wooshykeshcollege/turdsla_temp_files/V15.0/AIO/AIO.kicad_pcb

## KiCad design V15.0/AIO/AIO.kicad_pcb (2022-10-14)

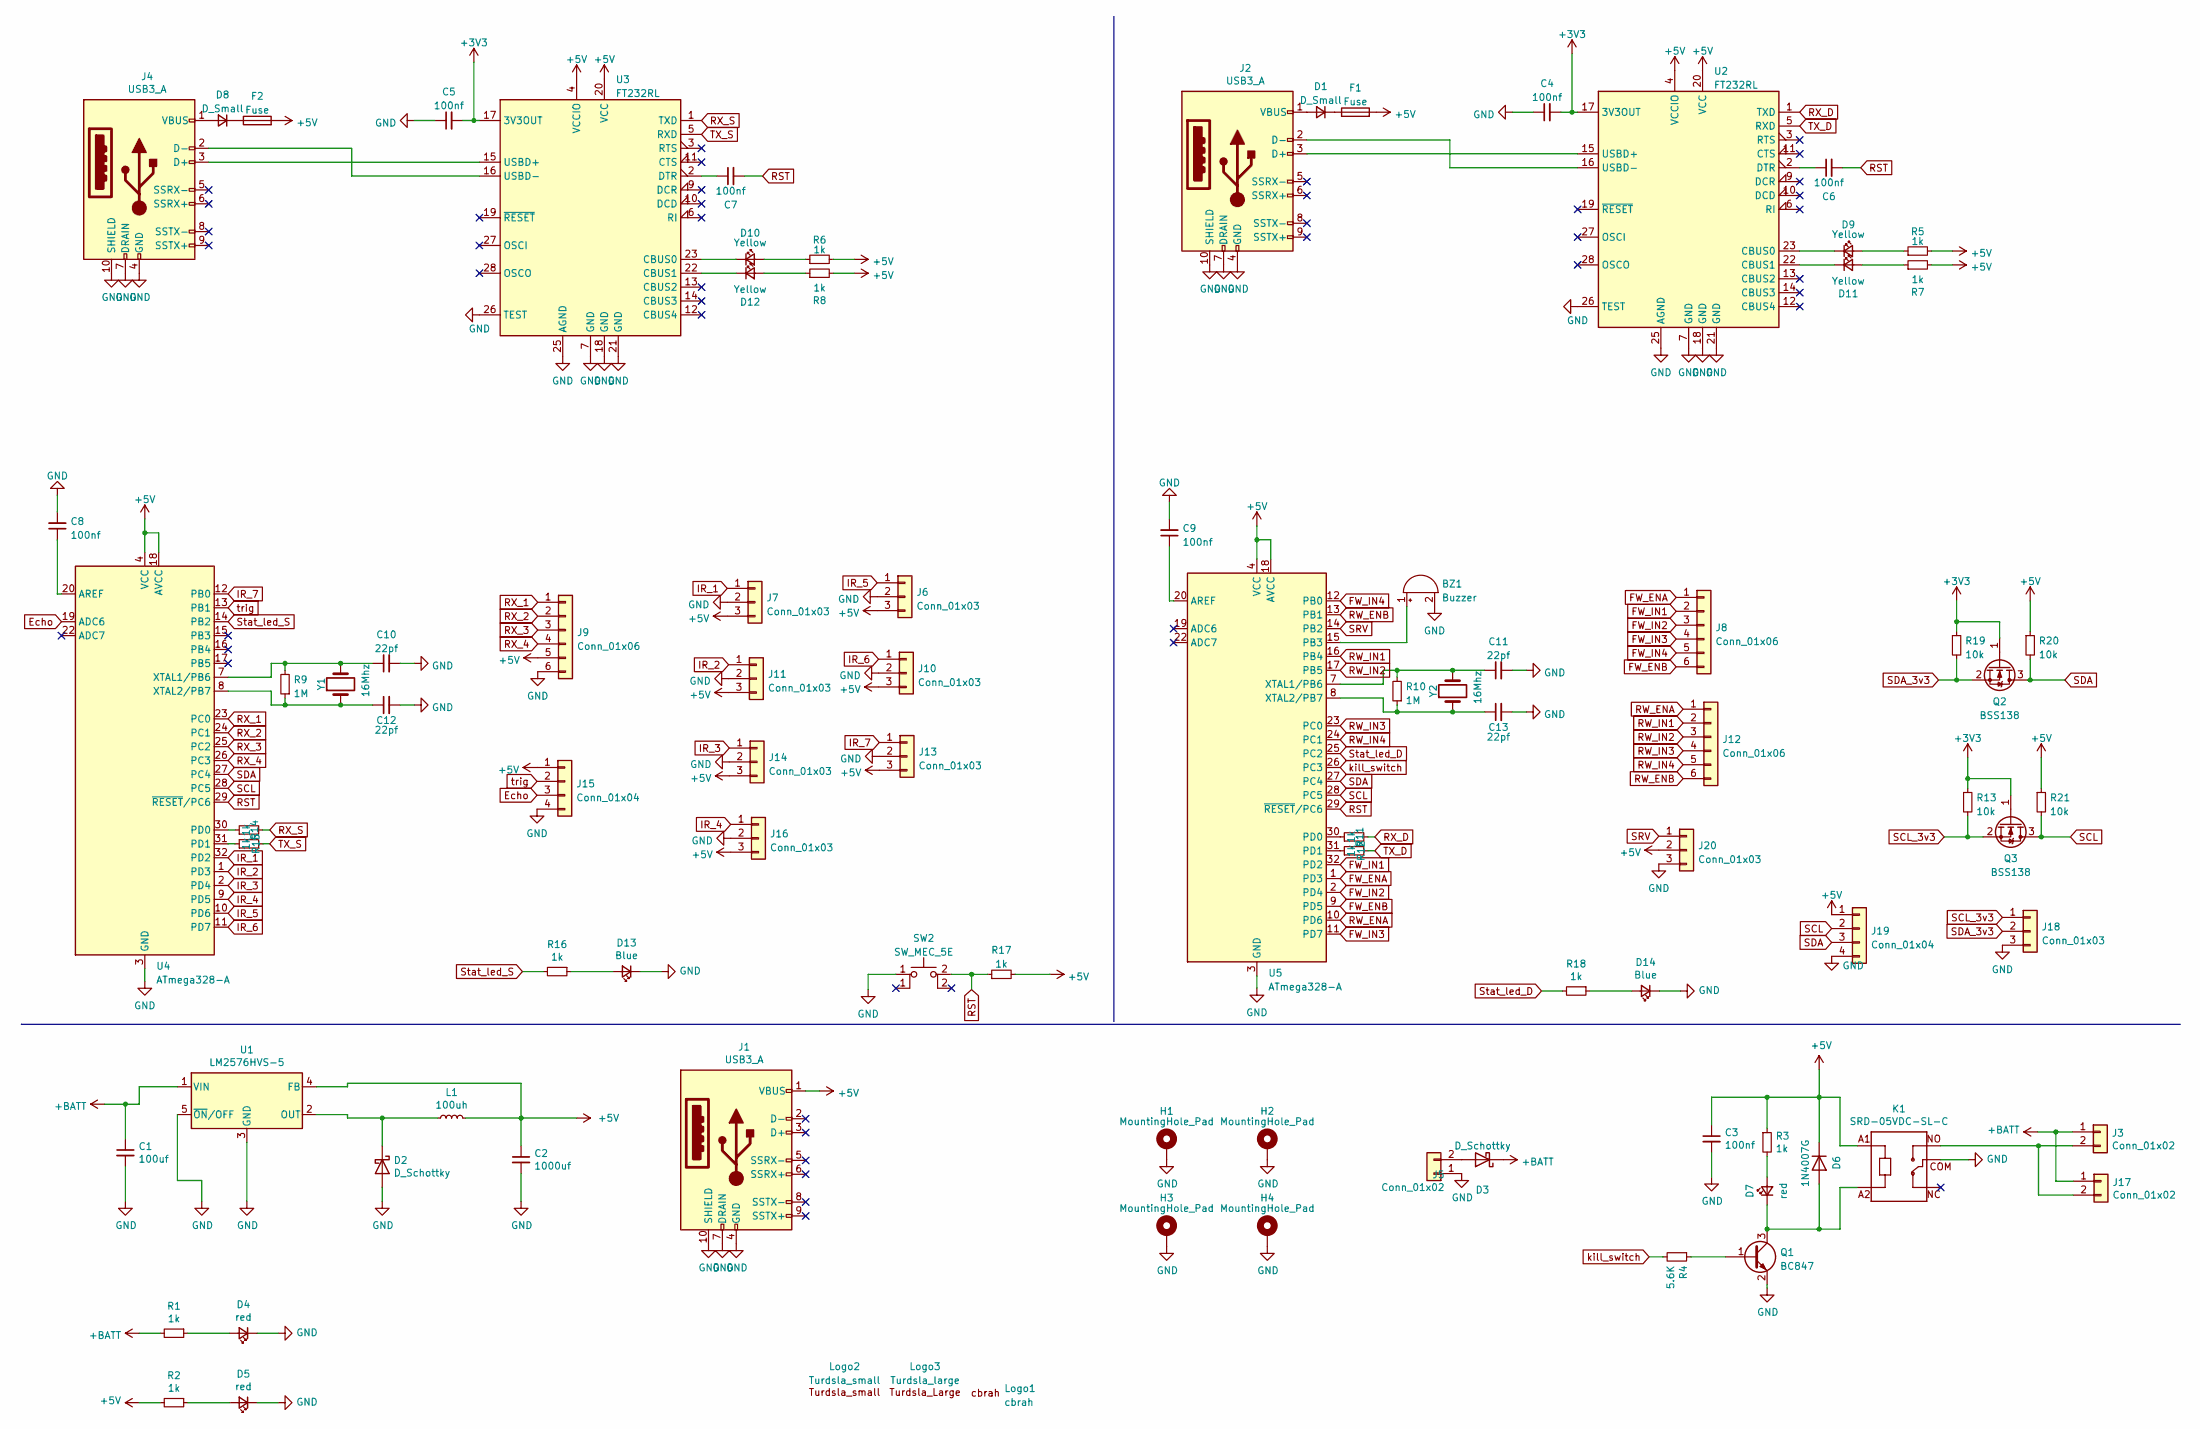
[picture p1: schematic AIO.kicad_sch]

Parts:
BZ1: Buzzer; MagneticBuzzer_ProSignal_ABI-009-RC
C1: 100uf; CP_Elec_6.3x7.7; LCSC PART# C72477
C2: 1000uf; cap_12.5x13.5; LCSC PART# C191226
C3, C4, C5, C6, C7, C8, C9: 100nf; C_1206_3216Metric; LCSC PART# C271438
C10, C11, C12, C13: 22pf; C_1206_3216Metric
D1, D8: D_Small; D_SOD-123
D2, D3: D_Schottky; schottky_diode; LCSC PART# C466483
D4, D5, D7: red; LED_1206_3216Metric; LCSC PART# C88326
D6: 1N4007G; SMAF; LCSC PART# C110856
D9, D10, D11, D12: Yellow; LED_1206_3216Metric; LCSC PART# C88326
D13, D14: Blue; LED_1206_3216Metric; LCSC PART# C88326
F1, F2: Fuse; Fuse_1210_3225Metric
H1, H2, H3, H4: MountingHole_Pad; MountingHole_3.2mm_M3_Pad_Via
J1, J2, J4: USB3_A; usb_3_female
J3, J17: Conn_01x02; TerminalBlock_bornier-2_P5.08mm
J5: Conn_01x02; AMASS_XT60-M_1x02_P7.20mm_Vertical
J6, J7, J10, J11, J13, J14, J16, J18, J20: Conn_01x03; PinHeader_1x03_P2.54mm_Vertical
J8, J9, J12: Conn_01x06; PinHeader_1x06_P2.54mm_Vertical
J15, J19: Conn_01x04; PinHeader_1x04_P2.54mm_Vertical
K1: SRD-05VDC-SL-C; Relay_SPDT_SANYOU_SRD_Series_Form_C; LCSC PART# C35449
L1: 100uh; LCSC PART# C408533
Logo1: cbrah; cbrah60
Logo2: Turdsla_small; Turdsla
Logo3: Turdsla_large
Q1: BC847; SOT-23
Q2, Q3: BSS138; SOT-23
R1, R2, R3, R5, R6, R7, R8, R11, R12, R14, R15, R16, R17, R18: 1k; R_1206_3216Metric; LCSC PART# C280032
R4: 5.6K; R_1206_3216Metric; LCSC PART# C844437
R9, R10: 1M; R_1206_3216Metric
R13, R19, R20, R21: 10k; R_1206_3216Metric; LCSC PART# C280032
SW2: SW_MEC_5E; SW_PUSH_6mm_H4.3mm
U1: LM2576HVS-5; TO-263-5_TabPin3; LCSC PART# C194472
U2, U3: FT232RL; SSOP-28_5.3x10.2mm_P0.65mm
U4, U5: ATmega328-A; TQFP-32_7x7mm_P0.8mm
Y1, Y2: 16Mhz; Crystal_SMD_SeikoEpson_MC405-2Pin_9.6x4.1mm

Connections:
+3V3: C4.2, C5.2, Q2.1 (G), Q3.1 (G), R13.1, R19.1, U2.17 (3V3OUT), U3.17 (3V3OUT)
+5V: C2.1, C3.1, D6.1 (K), F1.2, F2.2, J1.1 (VBUS), J6.3, J7.3, J9.5, J10.3, J11.3, J13.3, J14.3, J15.1, J16.3, J19.1, J20.2, K1.A1, L1.2, R2.2, R3.1, R5.2, R6.2, R7.2, R8.2, R17.2, R20.1, R21.1, U1.4 (FB), U2.4 (VCCIO), U2.20 (VCC), U3.4 (VCCIO), U3.20 (VCC), U4.4 (VCC), U4.6 (VCC), U4.18 (AVCC), U5.4 (VCC), U5.6 (VCC), U5.18 (AVCC)
+BATT: C1.1, D3.1 (K), J3.1, J17.1, R1.2, U1.1 (VIN)
Echo: J15.3, U4.19 (ADC6)
FW_ENA: J8.1, U5.1 (PD3)
FW_ENB: J8.6, U5.9 (PD5)
FW_IN1: J8.2, U5.32 (PD2)
FW_IN2: J8.3, U5.2 (PD4)
FW_IN3: J8.4, U5.11 (PD7)
FW_IN4: J8.5, U5.12 (PB0)
GND: BZ1.2 (+), C1.2, C2.2, C3.2, C4.1, C5.1, C8.2, C9.2, C10.2, C11.2, C12.2, C13.2, D2.2 (A), D4.1 (K), D5.1 (K), D13.1 (K), D14.1 (K), H1.1, H2.1, H3.1, H4.1, J1.4 (GND), J1.7 (DRAIN), J1.10 (SHIELD), J2.4 (GND), J2.7 (DRAIN), J2.10 (SHIELD), J4.4 (GND), J4.7 (DRAIN), J4.10 (SHIELD), J5.1, J6.2, J7.2, J9.6, J10.2, J11.2, J13.2, J14.2, J15.4, J16.2, J18.3, J19.4, J20.3, K1.COM, Q1.2 (E), SW2.1, U1.3 (GND), U1.5 (~ON/OFF), U2.7 (GND), U2.18 (GND), U2.21 (GND), U2.25 (AGND), U2.26 (TEST), U3.7 (GND), U3.18 (GND), U3.21 (GND), U3.25 (AGND), U3.26 (TEST), U4.3 (GND), U4.5 (GND), U4.21 (GND), U5.3 (GND), U5.5 (GND), U5.21 (GND)
IR_1: J7.1, U4.32 (PD2)
IR_2: J11.1, U4.1 (PD3)
IR_3: J14.1, U4.2 (PD4)
IR_4: J16.1, U4.9 (PD5)
IR_5: J6.1, U4.10 (PD6)
IR_6: J10.1, U4.11 (PD7)
IR_7: J13.1, U4.12 (PB0)
unnamed: BZ1.1 (-), U5.15 (PB3)
unnamed: C6.1, U2.2 (DTR)
unnamed: C7.1, U3.2 (DTR)
unnamed: C8.1, U4.20 (AREF)
unnamed: C9.1, U5.20 (AREF)
unnamed: C10.1, R9.2, U4.7 (XTAL1/PB6), Y1.2
unnamed: C11.1, R10.2, U5.7 (XTAL1/PB6), Y2.2
unnamed: C12.1, R9.1, U4.8 (XTAL2/PB7), Y1.1
unnamed: C13.1, R10.1, U5.8 (XTAL2/PB7), Y2.1
unnamed: D1.1 (K), F1.1
unnamed: D1.2 (A), J2.1 (VBUS)
unnamed: D2.1 (K), L1.1, U1.2 (OUT)
unnamed: D4.2 (A), R1.1
unnamed: D5.2 (A), R2.1
unnamed: D6.2 (A), D7.1 (K), K1.A2, Q1.3 (C)
unnamed: D7.2 (A), R3.2
unnamed: D8.1 (K), F2.1
unnamed: D8.2 (A), J4.1 (VBUS)
unnamed: D9.1 (K), U2.23 (CBUS0)
unnamed: D9.2 (A), R5.1
unnamed: D10.1 (K), U3.23 (CBUS0)
unnamed: D10.2 (A), R6.1
unnamed: D11.1 (K), U2.22 (CBUS1)
unnamed: D11.2 (A), R7.1
unnamed: D12.1 (K), U3.22 (CBUS1)
unnamed: D12.2 (A), R8.1
unnamed: D13.2 (A), R16.1
unnamed: D14.2 (A), R18.1
unnamed: J2.2 (D-), U2.16 (USBD-)
unnamed: J2.3 (D+), U2.15 (USBD+)
unnamed: J4.2 (D-), U3.16 (USBD-)
unnamed: J4.3 (D+), U3.15 (USBD+)
unnamed: D3.2 (A), J5.2
unnamed: J3.2, J17.2, K1.NO
unnamed: Q1.1 (B), R4.1
unnamed: R11.1, U5.30 (PD0)
unnamed: R12.1, U5.31 (PD1)
unnamed: R14.1, U4.30 (PD0)
unnamed: R15.1, U4.31 (PD1)
RST: C6.2, C7.2, R17.1, SW2.2, U4.29 (~RESET/PC6), U5.29 (~RESET/PC6)
RW_ENA: J12.1, U5.10 (PD6)
RW_ENB: J12.6, U5.13 (PB1)
RW_IN1: J12.2, U5.16 (PB4)
RW_IN2: J12.3, U5.17 (PB5)
RW_IN3: J12.4, U5.23 (PC0)
RW_IN4: J12.5, U5.24 (PC1)
RX_1: J9.1, U4.23 (PC0)
RX_2: J9.2, U4.24 (PC1)
RX_3: J9.3, U4.25 (PC2)
RX_4: J9.4, U4.26 (PC3)
RX_D: R11.2, U2.1 (TXD)
RX_S: R14.2, U3.1 (TXD)
SCL: J19.2, Q3.3 (D), R21.2, U4.28 (PC5), U5.28 (PC5)
SCL_3v3: J18.1, Q3.2 (S), R13.2
SDA: J19.3, Q2.3 (D), R20.2, U4.27 (PC4), U5.27 (PC4)
SDA_3v3: J18.2, Q2.2 (S), R19.2
SRV: J20.1, U5.14 (PB2)
Stat_led_D: R18.2, U5.25 (PC2)
Stat_led_S: R16.2, U4.14 (PB2)
TX_D: R12.2, U2.5 (RXD)
TX_S: R15.2, U3.5 (RXD)
kill_switch: R4.2, U5.26 (PC3)
trig: J15.2, U4.13 (PB1)

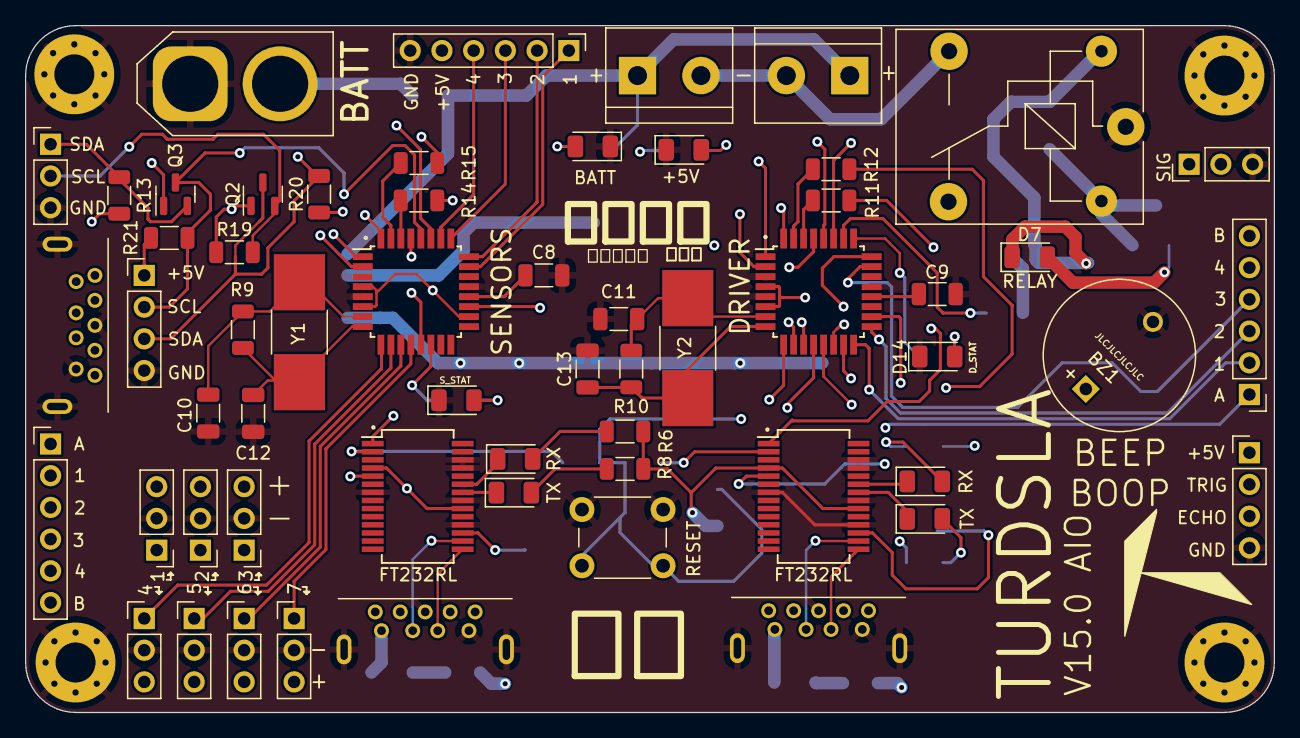
[picture p2: board AIO.kicad_pcb from above]

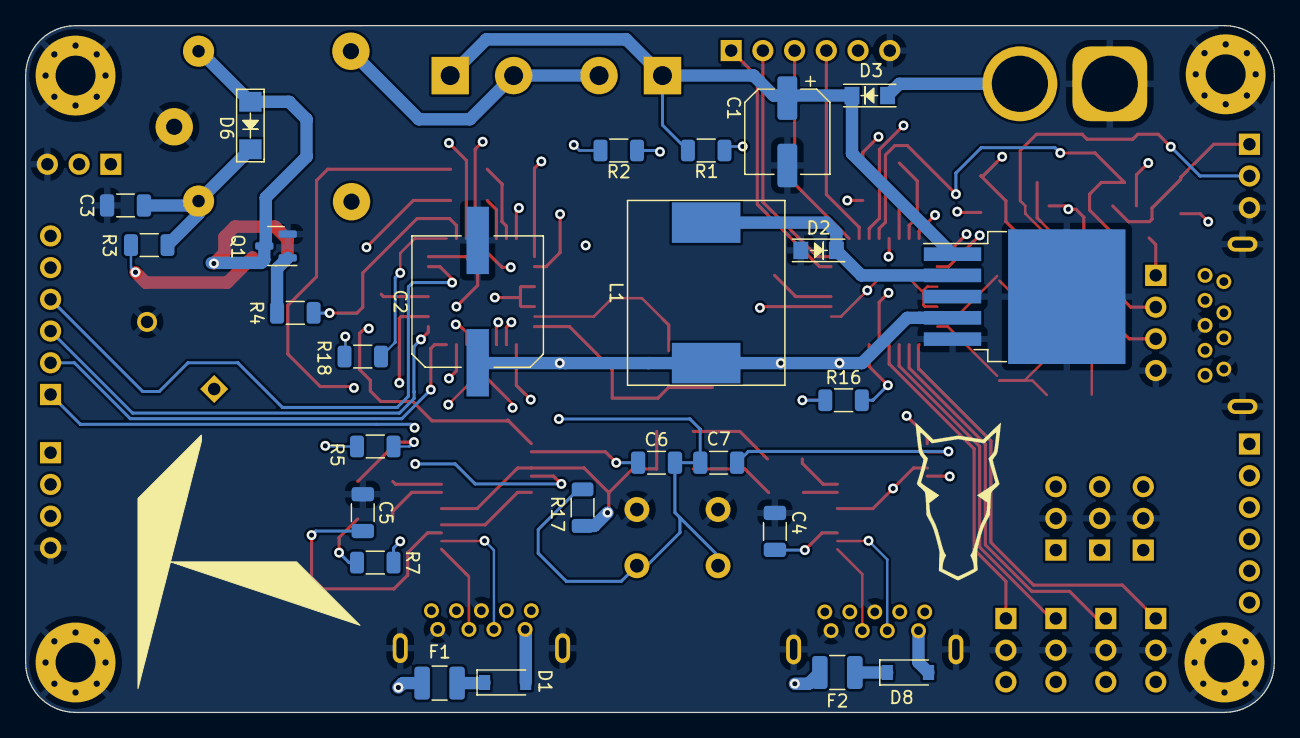
[picture p3: board AIO.kicad_pcb from below]

Board: 4 copper layers, 100.0 x 55.0 mm, 91 parts (28 on the bottom side), 81 nets.
