wooshykeshcollege/turdsla_temp_files/Tests/two/testcase.txt

Rhishikesh
9028
21
50
Hayden Blunt  
Temika Michels  
Tonya Luke  
Hanh Patino  
Denna Engelbrecht  
Alina Hilliard  
Woodrow Steen  
Rosana Marx  
Rodger Plummer  
Viola Bartel  
Tiara Herriman  
Dianna Proto  
Ruben Smolka  
Ammie Corwin  
Mariam Steinert  
Lon Stracener  
Gladis Stultz  
Lilly Hussey  
Tai Milum  
Lenna Chesnutt  
Pamela Casselman  
Jonathon Risko  
Betsey Campas  
Kathlyn Mckean  
Lashunda Wikoff  
Nubia Bortle  
Guillermina Chuang  
Esteban Burge  
Jenifer Cone  
Titus Portner  
Ranee Tickle  
Yolando Lomonaco  
Micheal Barbee  
Suzan Offutt  
Drew Higgin  
Elisha Beacham  
Jennine Parlin  
Terresa Masterson  
Page Goldenberg  
Velvet Redel  
Kylee Hudgens  
Hien Crase  
Antonio Gillan  
Sharri Beverley  
Anabel Sutterfield  
Aura Galey  
Renetta Corriveau  
Dennise Maharaj  
Zetta Caison  
Lexie Ebel
