wooshykeshcollege/turdsla_temp_files/Tests/Three/todrive.png

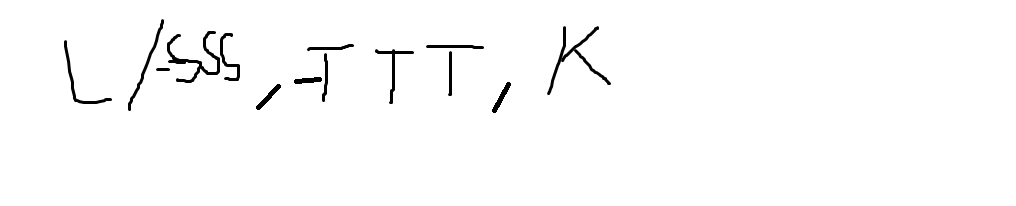
Tests/Three/todrive.png
